TangGuoHua/smarthome/Docs/PIR.jpg

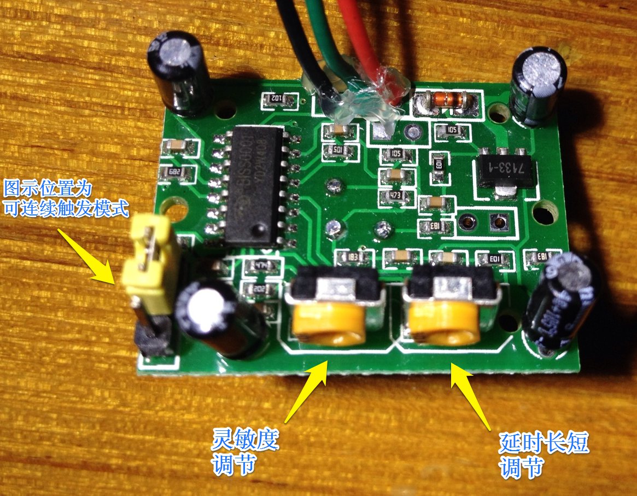
Docs/PIR.jpg
