TangGuoHua/smarthome/MCU/综合测试2/节点12 PWM调光/readme.txt

STC12C5608AD 1T单片机 4M外部晶振
主卧LED灯通过PWM调光
nrf24L01接收2个字节。字节1控制灯的亮度和延时关，字节2暂时没用
