TangGuoHua/smarthome/MCU/综合测试2/节点17 书房顶灯控制器/readme.txt

尽管这些文件都叫“报警器控制器XXX”，但是本节点确实用于控制书房的顶灯。
STC 11F04e 1T单片机
内部RC振荡器
nrf24L01无线模块
继电器
