TangGuoHua/smarthome/MCU/综合测试2/节点18 次卧控制器/readme.txt

节点18， 次卧控制器，ID1＝100， ID2＝18
STC11F04E 1T单片机 6.38MHz内部RC振荡器
NRF24L01+无线模块 (接收4个字节）
AM2321温湿度传感器 (DS18B20温度传感器 2013－FEB－27更换为AM2321)
2个继电器 分别控制床头灯（可以延时关）和加热器（可以控制温度）
