TangGuoHua/smarthome/MCU/综合测试2/节点15 电子钟/readme.txt

STC12C5608AD 
4M 外部晶振
nrf24L01+
4位共阳数码管
ds18B20 测温度

温度、时间交替显示
每5分钟通过nrf24L01传送一次当前亮度值和温度值
通过nrf24L01接受来自主机的校时信号
