TangGuoHua/smarthome/MCU/综合测试2/节点7 客厅控制器/readme.txt

STC 1T 12C5608AD 内部RC振荡 约7Mhz
AM2301 温湿度
NRF24L01 无线
2个继电器 

节点每5分钟发送一次温湿度值
节点接受来至主机的命令，控制继电器开闭
