TangGuoHua/smarthome/MCU/综合测试2/节点10_遥控灯开关/readme.txt

STC12C5608AD + 4M external crystal + NRF24L01P
遥控客厅的灯开
