TangGuoHua/smarthome/Docs/智能家控制器接线图.PNG

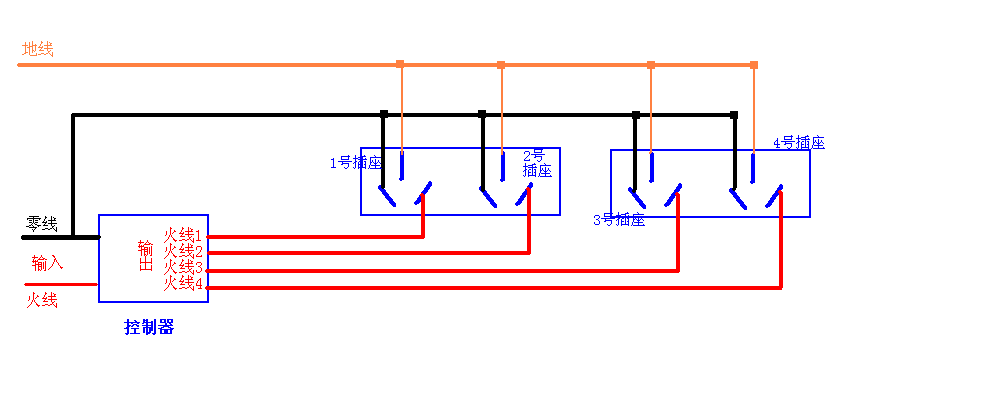
Docs/智能家控制器接线图.PNG
