TangGuoHua/smarthome/Docs/智能家架构.png

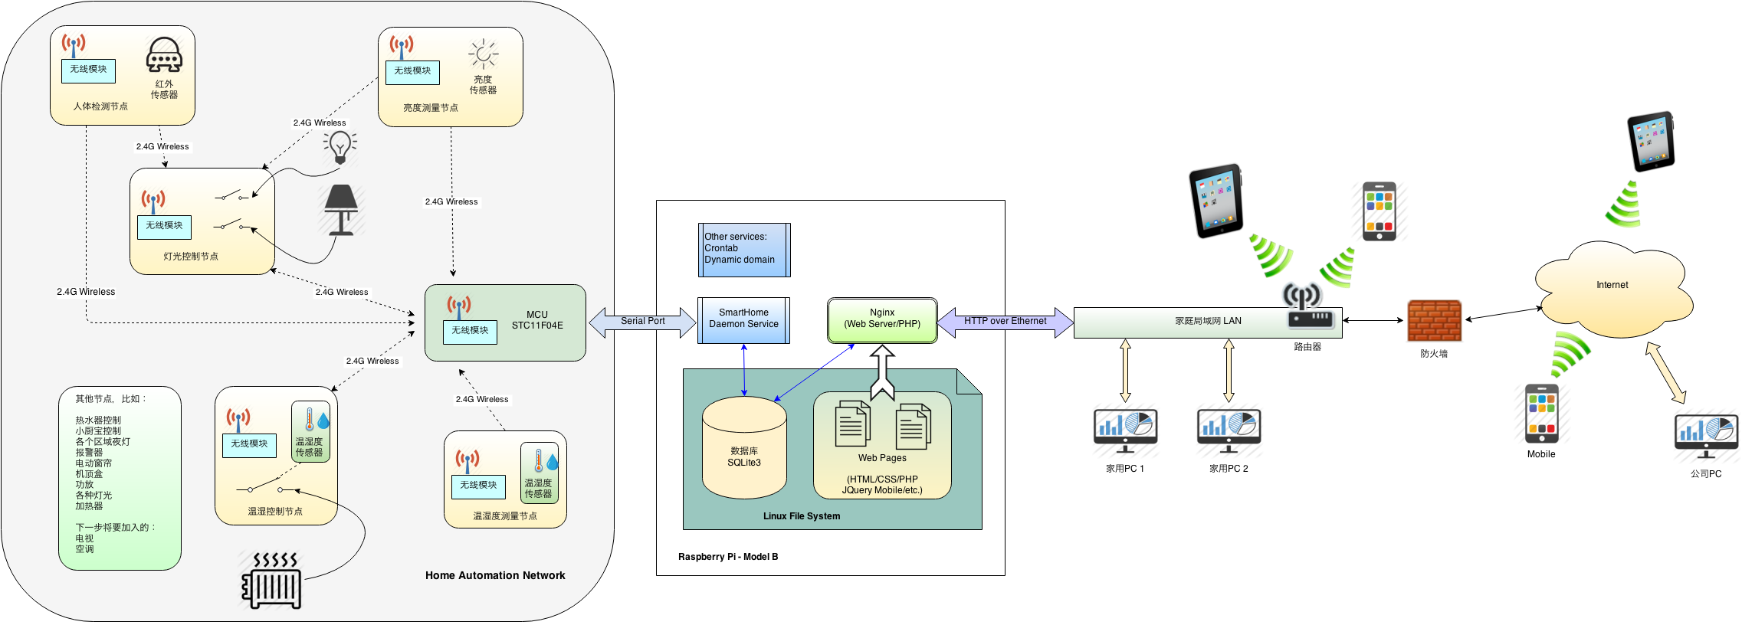
Docs/智能家架构.png
