TangGuoHua/smarthome/MCU/综合测试2/Doc/Node.xls

Sheet: 节点
编号 | 节点ID |  | 24L01接收频道 | 24L01接收地址 |  |  | 24L01接收字节数 | 节点描述
 | 字节0 | 字节1 |  | 字节0 | 字节1 | 字节2
1 | 48 | 1 | 96 | 54 | 69 | 149 | 15 | 主机节点，用于和上位机通信
2 | 144 | 1 | 92 | 97 | 83 | 149 | 2 | 温湿度节点。该节点具有一个DHT11湿度传感器和一个DS8B20温度传感器，一旦打开电源，每5秒，该节点将会向主节点发送一次温湿度数据。
3 | 144 | 2 | 92 | 97 | 83 | 153 | 0 | 热释电红外节点。该节点具有一个热释电红外传感器。一旦检测到信号，该节点将会发送一个数据包给主机。

Sheet: 说明
列名 | 说明
编号 | 从1开始的连续顺序号。显示表格的行号，统计节点个数等用处
节点ID | 这是我们自己的协议为每个节点编的一个ID号，每个节点的ID必须唯一，各节点间不能有重复ID出现。 每个节点的ID由2个字节组成。 高位字节（字节H）用于表示节点的类型。目前只有主节点（Master）和从节点（Slave）两种。一个类型下最多可以有256个节点（这个由下面的ID低位字节L决定）。 Master：0x30 Slave: 0x90 低位字节（字节L）用于表示某类型下节点的编号。取值范围是0到255。一般从1开始按顺序为该类型下的节点编号。 将高低两个字节组合在一起，就成为了一个2字节整型数，这个数可以用于上位机系统里面标识某一节点的唯一ID。 表格里面的十六进制和十进制数就是这个双字节整数。 理论上，我们的系统里面可以容纳的最大节点数是65536个，从0x0000-0xffff。
24L01接收频道 | 这是24L01的一个定义，即设定24L01为PRX时，其监听的频道是哪一个。 24L01支持0－125共126个频道，这个频道数（CH）也决定了24L01的接收频率，接收频率F=2400+CH （MHz）。 目前，在各个节点间通信时，我们使用同一个频道。（这个频道应该经过试验选择与现场干扰最小的频道，避开无线路由器等。) 另外，我看到网友的一个测试结果：发送频率越低，发送功率越高（我只是看到这个结果，网友没有说明测试条件等等，故此信息仅供参考。） 可以自己试验测试一下不同频率上的丢包率等来确定通信频率。
24L01接收地址 | 这是24L01的一个定义，即在设定24L01为PRX时为其设置的地址。这个地址决定了节点的接收地址。 我们的系统使用3字节地址，即，每个地址由3个字节组成：字节0、字节1、字节2.（24L01支持3－5个字节地址） 每个节点的硬件地址必须各不相同，不能有重复。 每个节点的硬件地址不得改变。 根据24L01的Datasheet：对于那些电平只有一次跳变（例如: 0x0000ff, 0xff8000等）和连续做高低跳变（例如：0xaaaaaa,0x555555等）的地址都容易引起系统误判为干扰，故不建议使用。 我们使用的地址规律：目前没有。（可以通过试验测试什么样的地址丢包率低,etc.）
24L01接收字节数 | 节点接收的每帧数据的字节数。取值范围0－32 这是24L01的定义，即设置24L01为PRX时，为其设定的每帧接收字节数。24L01每帧数据最多为32个字节。当初始化24L01为PRX时，这个值就定下来了。 如果一个节点接收字节数为0，则表示该节点不接收外界数据，即24L01不会工作在PRX模式。（这是我们自己协议的定义） 每个节点具体接收的报文内容请参考各节点的说明书。
