TangGuoHua/smarthome/PCB/controller.brd

## EAGLE design PCB/controller.brd (2015-01-24)

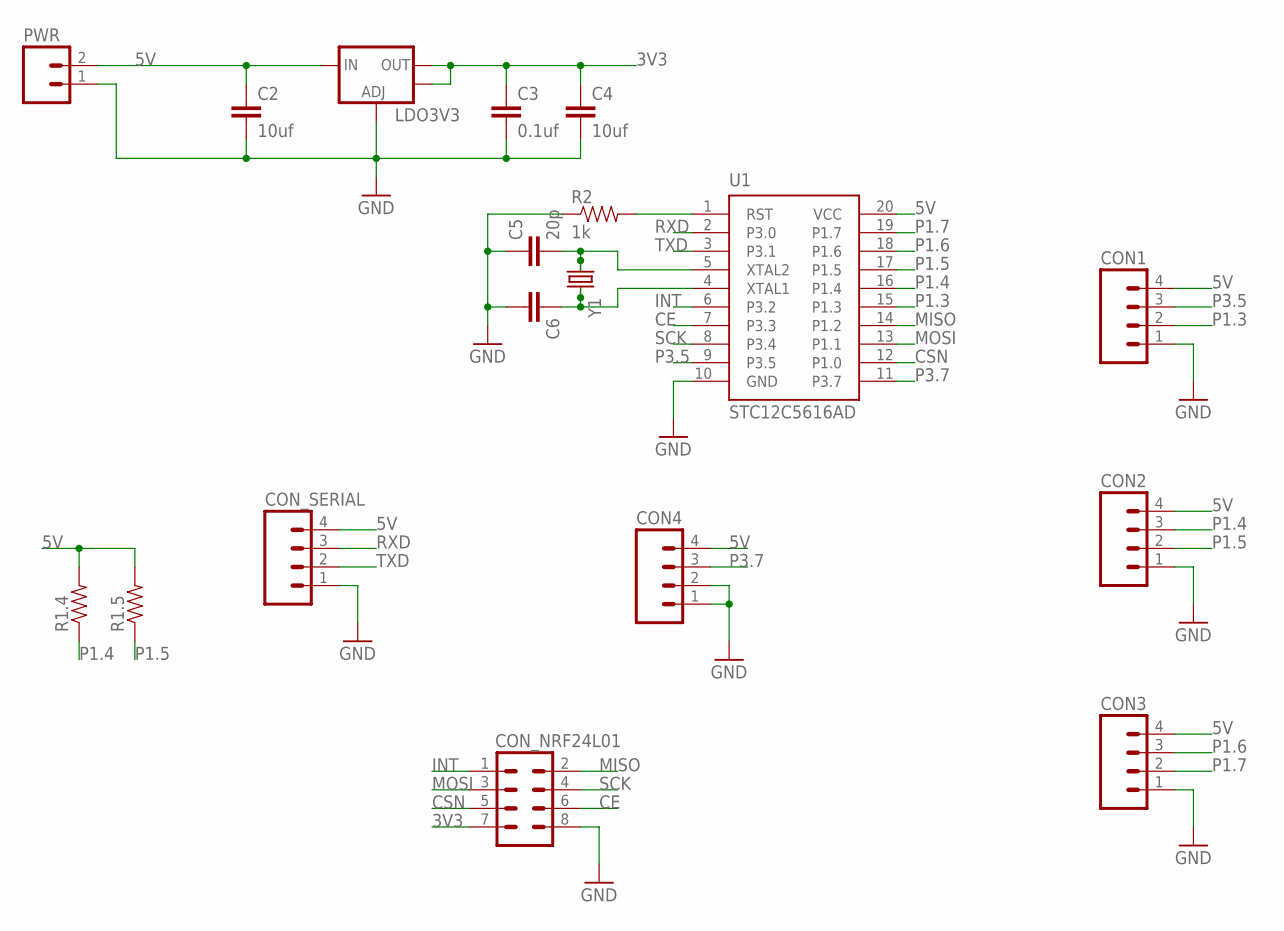
[picture p4: schematic controller.sch]

Parts:
C2, C4: 10uf; 0805
C3: 0.1uf; 0805
C5: 20p; 0603-CAP
C6: CAP0603-CAP; 0603-CAP
CON1, CON2, CON3, CON4: M04PTH; 1X04
CON_NRF24L01: M04X2; 2X4
CON_SERIAL: M04PTH; 1X04
LDO3V3: V_REG_LM1117SOT223; SOT223
PWR: M02PTH; 1X02
R1.4, R1.5: RESISTOR0805-RES; 0805
R2: 1k; 0805
U1: STC12C5616AD; SOP20
Y1: CRYSTALHC49US; HC49US

Connections:
3V3: C3.1, C4.1, CON_NRF24L01.7, LDO3V3.2 (OUT), LDO3V3.4 (OUT)
5V: C2.1, CON1.4, CON2.4, CON3.4, CON4.4, CON_SERIAL.4, LDO3V3.3 (IN), PWR.2, R1.4.2, R1.5.2, U1.20 (VCC)
CE: CON_NRF24L01.6, U1.7 (P3.3)
CSN: CON_NRF24L01.5, U1.12 (P1.0)
GND: C2.2, C3.2, C4.2, C5.1, C6.2, CON1.1, CON2.1, CON3.1, CON4.1, CON4.2, CON_NRF24L01.8, CON_SERIAL.1, LDO3V3.1 (ADJ), PWR.1, R2.1, U1.10 (GND)
INT: CON_NRF24L01.1, U1.6 (P3.2)
MISO: CON_NRF24L01.2, U1.14 (P1.2)
MOSI: CON_NRF24L01.3, U1.13 (P1.1)
unnamed: C5.2, U1.5 (XTAL2), Y1.1
unnamed: C6.1, U1.4 (XTAL1), Y1.2
unnamed: R2.2, U1.1 (RST)
P1.3: CON1.2, U1.15 (P1.3)
P1.4: CON2.3, R1.4.1, U1.16 (P1.4)
P1.5: CON2.2, R1.5.1, U1.17 (P1.5)
P1.6: CON3.3, U1.18 (P1.6)
P1.7: CON3.2, U1.19 (P1.7)
P3.5: CON1.3, U1.9 (P3.5)
P3.7: CON4.3, U1.11 (P3.7)
RXD: CON_SERIAL.3, U1.2 (P3.0)
SCK: CON_NRF24L01.4, U1.8 (P3.4)
TXD: CON_SERIAL.2, U1.3 (P3.1)

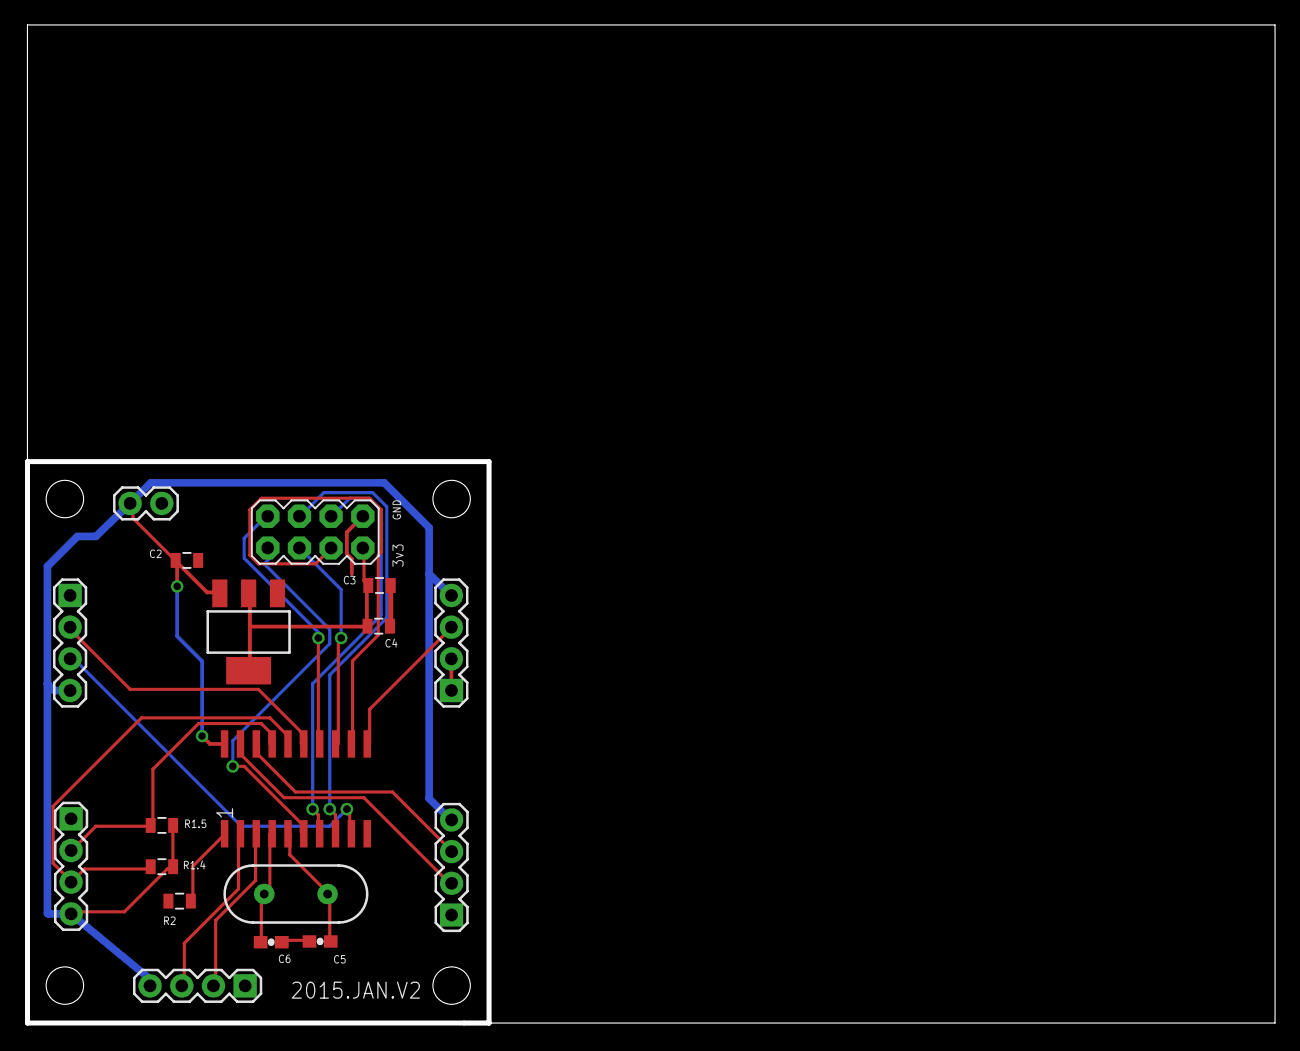
[picture p5: board controller.brd from above]

Board: 2 copper layers, 100.0 x 80.0 mm, 18 parts (0 on the bottom side), 21 nets.
