TangGuoHua/smarthome/Pi/smartHome/c/v2/nrf24L01.c

/***************************************************************************
【修改历史】

日期            作者    备注
----------------------------------------------------------------------
2014年08月20日  黄长浩  初始版本
2014年08月20日  黄长浩  修改nrfSendData()函数，增加rfPower, maxRetry参数
2014年09月23日  黄长浩  修改nrfSendData()函数，由于改用了带PA的模块（模块的LNA使能和CE相连），所以在发送数据后不能马上让CE=0，
                        一定要等收到ACK或者等发送失败后，才能让CE＝0。
2014年09月27日  黄长浩  修改nrfSendData()函数，使重发等待时间由1500us降到500us
                        修改nrfSetRxMode()和nrfSendData()函数，纠正以前地址宽度未设置的问题
2014年10月15日  黄长浩  nrfDataAvailable()取代nrfIsDataReceived()
                        nrfGetOneDataPacket()取代nrfGetReceivedData()
						支持从缓存FIFO读取多字节数据

【版权声明】
Copyright(C) All Rights Reserved by Changhao Huang (HuangChangHao@gmail.com)
版权所有者：黄长浩 HuangChangHao@gmail.com

未经作者书面授权，不可以将本程序此程序用于任何商业目的。
用于学习与参考目的，请在引用处注明版权和作者信息。
*****************************************************************************/

#include <wiringPi.h>
#include <stdio.h>
//#include <unistd.h>
#include "nrf24L01Def.h"

void nrfFlushTx();
void nrfFlushRx();
unsigned char nrfCheckSendStatus();

unsigned char nrfSPI( unsigned char spiData );
unsigned char nrfReadReg(  unsigned char regAddr );
unsigned char nrfWriteReg( unsigned char regAddr, unsigned char writeData);
unsigned char nrfReadRxData( unsigned char regAddr, unsigned char *rxData, unsigned char dataLen);
unsigned char nrfWriteTxData(unsigned char regAddr, unsigned char *txData, unsigned char dataLen);



//********* 以下函数仅供本模块内部调用 **************
//SPI时序函数
unsigned char nrfSPI( unsigned char spiData )
{
	unsigned char i;
	for(i=0;i<8;i++) //循环8次
	{
		if( spiData & 0x80 )
			//MOSI=1;
			digitalWrite( MOSI, HIGH );
		else
			digitalWrite( MOSI, LOW ); //byte最高位输出到MOSI
		spiData<<=1; //低一位移位到最高位
		//SCLK=1; 
		digitalWrite( SCLK, HIGH );
		
		//if(MISO) //拉高SCK，nRF24L01从MOSI读入1位数据，同时从MISO输出1位数据
		if( digitalRead( MISO )) 
			spiData|=0x01; //读MISO到byte最低位
		
		//SCLK=0; //SCK置低
		digitalWrite( SCLK, LOW );
	}
	return(spiData); //返回读出的一字节
}

//SPI读寄存器一字节函数
unsigned char nrfReadReg( unsigned char regAddr )
{
	unsigned char returnData;
	//CSN=0;//启动时序
	digitalWrite( CSN, LOW );
	nrfSPI( regAddr );//写寄存器地址
	returnData=nrfSPI(0x00);//写入读寄存器指令  
	//CSN=1;
	digitalWrite( CSN, HIGH );
	return( returnData ); //返回状态
}

//SPI写寄存器一字节函数
unsigned char nrfWriteReg( unsigned char regAddr, unsigned char writeData )
{
	unsigned char returnData;
	//CSN=0;//启动时序
	digitalWrite( CSN, LOW );
	returnData=nrfSPI(regAddr);//写入地址
	nrfSPI(writeData);//写入值
	//CSN=1;
	digitalWrite( CSN, HIGH );
	return(returnData);
}

//SPI读取RXFIFO寄存器的值
unsigned char nrfReadRxData( unsigned char regAddr, unsigned char *rxData, unsigned char dataLen )
{  //寄存器地址//读取数据存放变量//读取数据长度//用于接收
	unsigned char returnData,i;
	//CSN=0;//启动时序
	digitalWrite( CSN, LOW );
	returnData=nrfSPI(regAddr);//写入要读取的寄存器地址
	for(i=0;i<dataLen;i++) //读取数据
	{
		rxData[i]=nrfSPI(0);
	} 
	//CSN=1;
	digitalWrite( CSN, HIGH );
	return(returnData); 
}


//SPI写入TXFIFO寄存器的值
unsigned char nrfWriteTxData( unsigned char regAddr, unsigned char *txData, unsigned char dataLen )
{ //寄存器地址//写入数据存放变量//读取数据长度//用于发送
	unsigned char returnData,i;
	//CSN=0;
	digitalWrite( CSN, LOW );
	returnData=nrfSPI(regAddr);//写入要写入寄存器的地址
	for(i=0;i<dataLen;i++)//写入数据
	{
		nrfSPI(*txData++);
	}
	//CSN=1;
	digitalWrite( CSN, HIGH);
	return(returnData);
}


//Flush Tx Buffer
void nrfFlushTx()
{
	digitalWrite( CSN, LOW );//CSN=0;
	nrfSPI(FLUSH_TX);
	digitalWrite( CSN, HIGH );//CSN=1; 
}

//Flush Rx Buffer
void nrfFlushRx()
{
	digitalWrite( CSN, LOW );//CSN=0;
	nrfSPI(FLUSH_RX); 
	digitalWrite( CSN, HIGH );//CSN=1;
}


// 用于检查发送状态
// 返回值：252-不应该出现的返回值。（中断触发了，但既不是TX_DS也不是MAX_RT）
//         255-表示大重发次数达到后仍然未收到ACK，发送失败
//         0到15的一个值，表示发送完成且成功。返回值是自动重发的次数，例如：
//           0：没有重发，直接发送成功
//           1: 重发了1次后成功收到ack
//           2: 重发了2次后成功收到ack
//           以此类推
//           最大值是SETUP_RETR这个寄存器里面设置的最大重发次数。（不会超过15）
unsigned char nrfCheckSendStatus()
{
	unsigned char status;

	status = nrfReadReg(R_REGISTER+STATUS); //读取状态寄存器

	if( status & 0x20 ) //检查TX_DS位，置位则发送成功
	{
		nrfWriteReg(W_REGISTER+STATUS,0x7f);  // 清除TX_DS标志
		
		//发送成功后，FIFO自动清空，这里就不用再清了
		
		//返回自动重发次数
		return( nrfReadReg(R_REGISTER+OBSERVE_TX) & 0x0f ); 
	}
	else if( status & 0x10 ) //检查MAX_RT位，置位则说明最大重发次数达到后仍然未收到ACK，发送失败
	{
		nrfWriteReg(W_REGISTER+STATUS,0x7f);  // 清除MAX_RT标志
		
		//发送失败，FIFO不会自动清空，必须手动清空 ！！
		//关键！！不然会出现意想不到的后果！！！
		nrfFlushTx();

		return 255;
	}
	else
	{
		return 252; //不应该出现的一个值
	}
}


//******* 以下函数供外部模块调用 ************

//NRF24L01初始化函数
void nrf24L01Init()
{
	// initialize wiringPi lib
	wiringPiSetup();
	
	//Set pin mode
	pinMode( CE, OUTPUT );
	pinMode( CSN, OUTPUT );
	pinMode( SCLK, OUTPUT );
	pinMode( MOSI, OUTPUT );
	pinMode( MISO, INPUT );
	pinMode( IRQ, INPUT );
	
	//Set pull-ups
	pullUpDnControl( MISO, PUD_UP );
	pullUpDnControl( IRQ, PUD_UP );
	
	//delayFor24L01();//让系统什么都不干
	//delayFor24L01();//让系统什么都不干
	
	//CE=0; //待机模式1 (Standy-I)
	digitalWrite( CE, LOW );
	
	//CSN=1;
	digitalWrite( CSN, HIGH );
	
	//SCLK=0;
	digitalWrite( SCLK, LOW );
	
	/***下面这些寄存器的配置，在这个程序运行期间不变化，故在初始化芯片时配置。***/
	nrfWriteReg( W_REGISTER+EN_AA, 0x01 );     // 使能接收通道0自动应答
	nrfWriteReg( W_REGISTER+EN_RXADDR, 0x01 ); // 使能接收通道0

	//nrfWriteReg( W_REGISTER+SETUP_AW, 0x03 ); // Set up address width to 5 bytes
	nrfWriteReg( W_REGISTER+SETUP_RETR,0x7f ); // 自动重发延时等待2000us，自动重发15次
	nrfWriteReg( W_REGISTER+STATUS, 0x7e ); //清除RX_DR,TX_DS,MAX_RT状态位
	nrfWriteReg( W_REGISTER+CONFIG, 0x7e ); //屏蔽3个中断，CRC使能，2字节CRC校验，上电，PTX

	//delayFor24L01();
	//delayFor24L01();
	
	//flush buffers
	nrfFlushTx();
	nrfFlushRx();
}


// 将24L01设置为发送模式PTX，并发送数据
// 参数如下：
// rfChannel: 无线电频道  取值范围是0-125（即，0x00到0x7d）
// rfPower: 发射功率 取值1-4，
//          rfPower=1, 发射功率-18dBm (+7dBm with PA) 
//          rfPower=2, 发射功率-12dBm (+15dBm with PA) 
//          rfPower=3, 发射功率-6dBm (+20dBm with PA) 
//          rfPower=4, 发射功率0dBm (+22dBm with PA) 
// maxRetry: 如果发送不成功，重试的最大次数 取值范围0-9
//           0:如果发送失败，（特指nrf24l01+芯片Re-transmit 15次后仍然不成功），那么不重试，直接返回
//           1:如果发送失败，（特指nrf24l01+芯片Re-transmit 15次后仍然不成功），重试1次。以此类推。
//           特别说明，retry和retransmit的区别是：
//             芯片被设定为每次发送数据，如果一次transmission不成功，则自动再重传（retransmit）15次
//             而retry是指，在芯片自动重传了15次后，还是不成功的情况下，再发送一轮，即transmit (1+15)=16次
// addrWidth: 发送地址宽度
// txAddr: 发送的地址（接收方地址）
// dataWidth: 发送数据的宽度
// txData: 发送的数据
// 例子：
// unsigned char rfChannel = 0x64; //选择无线电频道
// unsigned char rec_addr[3]= { 0x54, 0x53, 0x95 };  //接收方地址
// unsigned char data_to_send[5] = {0x01, 0x02, 0x03, 0x04, 0x05 };　//要发送的数据
// nrfSendData( rfChannel, 1, 3, 3, rec_addr, 5, data_to_send );  //发送
//
// 返回值：本函数返回数据发送成功时，芯片重传（Re-transmit）的次数。
//   返回0：没有re-transmit，直接发送成功
//   返回1: 表示芯片re-transmit 1次成功
//   返回2：表示芯片re-transmit 2次成功
//   以此类推，最多re-transmit 159次成功。
//
//   返回251或252：都是系统异常情况。（其实这两个值都不应出现。）
//   返回253：表示本函数的入口参数有超过取值范围的，需要检查入口参数。
//   返回255：表示达到了重发次数达到后仍然未收到ACK，发送失败
unsigned char nrfSendData( unsigned char rfChannel, unsigned char rfPower, unsigned char maxRetry, unsigned char addrWidth, unsigned char *txAddr, unsigned char dataWidth, unsigned char *txData )
{
	unsigned char ret = 0;
	unsigned char retryCnt = 0;

	//检测各个参数是否在允许的取值范围内
	if( rfChannel>125 || rfPower==0 || rfPower>4 || maxRetry>9 || addrWidth<3 || addrWidth>5 || dataWidth==0 || dataWidth>32 )
	{
		return 253;
	}
	
	digitalWrite( CE, LOW );

	nrfWriteReg( W_REGISTER+SETUP_AW, addrWidth-2 ); //设置地址宽度
	nrfWriteTxData( W_REGISTER+TX_ADDR, txAddr, addrWidth ); //写寄存器指令+接收地址使能指令+接收地址+地址宽度
	nrfWriteTxData( W_REGISTER+RX_ADDR_P0, txAddr, addrWidth ); //为了应答接收设备，接收通道0地址和发送地址相同
	
	if(rfPower==1)
		nrfWriteReg( W_REGISTER+RF_SETUP,0x21 ); //数据传输率250Kbps，发射功率-18dBm (+7dBm with PA), LNA?
	else if(rfPower==2)
		nrfWriteReg( W_REGISTER+RF_SETUP,0x23 ); //数据传输率250Kbps，发射功率-12dBm (+15dBm with PA), LNA?
	else if(rfPower==3)
		nrfWriteReg( W_REGISTER+RF_SETUP,0x25 ); //数据传输率250Kbps，发射功率-6dBm (+20dBm with PA), LNA?
	else if(rfPower==4)
		nrfWriteReg( W_REGISTER+RF_SETUP,0x27 ); //数据传输率250Kbps，发射功率0dBm (+22dBm with PA), LNA?


	nrfWriteReg( W_REGISTER+RF_CH, rfChannel ); //选择射频通道
	nrfWriteReg( W_REGISTER+STATUS, 0x7f ); //清除RX_DR,TX_DS,MAX_RT标志
	nrfWriteReg( W_REGISTER+CONFIG, 0x4e ); //屏蔽RX_DR中断, 使能TX_DS和MAX_RT中断，CRC使能，2字节CRC校验，上电，PTX
	
	for( retryCnt=0; retryCnt<=maxRetry; retryCnt++ )
	{
		nrfWriteTxData( W_TX_PAYLOAD, txData, dataWidth ); //写入要发送的数据
		
		digitalWrite( CE, HIGH );
		while( digitalRead( IRQ ) ); //等待发送完毕（成功或达到最大重传次数）
		digitalWrite( CE, LOW ); //因为要使用AA，所以等中断产生后才能使CE=0，否则LNA无法工作
		
		ret=nrfCheckSendStatus();

		//printf( "retry count:[%d]\r\n", retryCnt );
		
		//如果返回值小于等于15，说明本次数据传送成功
		if( ret<=15 ) 
		{
			//计算函数返回值，即Retransmission的次数
			//一次性发送成功，返回0，即没有重传(re-transmission)
			//retry第1次时，一次性发送成功，则retransit 16次 （之前15次加本次）
			//一次类推，
			//retry第9次时，（加开始retry之前的一次，共发射了10次），retransmit 15次成功，则，总共retransmit了16*9+15=159次
			//每次try是transmit 16次 （本身1次，加15次retransmit）
			ret += (16*retryCnt);
			break;
		}
	}


	//printf( "cnt=%ld\n\r", timeoutCnt );
	//printf( "sending done.\n\r");
	
	return ret;
}


//设置24L01为接收模式PRX，准备接收数据
//参数如下：
//rfChannel：接收的频道号。取值范围是0－125
//addrWidth: 地址宽度（3-5字节）
//rxAddr：本节点接收的地址
//本节点的接收数据宽度在"nrf24L01Node.h"头文件里面设置
//例：
//   unsigned char myAddr[3] = {53, 69, 160};
//   nrfSetRxMode( 76, 3, myAddr);
//那么节点将在76频道上接收数据。地址宽度为3字节，地址是：53/69/160。
//一旦接收到数据，将触发INT0 (硬件接线提示：IRQ需连接到INT0上）
void nrfSetRxMode( unsigned char rfChannel, unsigned char addrWidth, unsigned char *rxAddr )
{
    digitalWrite( CE, LOW );

	nrfWriteReg( W_REGISTER+SETUP_AW, addrWidth-2 ); //设置地址宽度
  	nrfWriteTxData( W_REGISTER+RX_ADDR_P0, rxAddr, addrWidth ); //接收设备接收通道0使用和发送设备相同的发送地址
	nrfWriteReg( W_REGISTER+RF_CH, rfChannel ); //设置射频通道
  	nrfWriteReg( W_REGISTER+RX_PW_P0, RECEIVE_DATA_WIDTH ); //接收通道0选择和发送通道相同有效数据宽度
  	nrfWriteReg( W_REGISTER+RF_SETUP,0x27 ); // 数据传输率250Kbps，发射功率0dBm (+22dBm with PA), LNA?
	nrfWriteReg( W_REGISTER+STATUS, 0x7f ); // 清除RX_DR,TX_DS,MAX_RT标志
	nrfWriteReg( W_REGISTER+CONFIG, 0x3f ); //使能RX_DR中断，屏蔽TX_DS和MAX_RT中断，CRC使能，2字节CRC校验，上电，接收模式

  	digitalWrite( CE, HIGH ); //设为接收模式 PRX
}




//获取24L01接收到的一帧数据。
//由于nrf带有3个FIFO，所以应该用调用nrfDataAvailable()，循环读取一帧帧数据，直到nrfDataAvailable()返回0为止。
//注意：调用本函数前，请调用nrfDataAvailable()函数，确认有数据收到后，再调用本方法来取得24L01收到的数据
unsigned char* nrfGetOneDataPacket()				 
{
	static unsigned char dataBuffer[RECEIVE_DATA_WIDTH];
	//unsigned char status;
	
	//有人建议CE=0，再读取数据

	// 从RX FIFO读取数据
	nrfReadRxData(R_RX_PAYLOAD,dataBuffer,RECEIVE_DATA_WIDTH);
		
	return dataBuffer;
}


//是否收到数据?
//返回值: 1-收到数据， 0-未收到数据
//注意：本方法只能在PRX模式下使用！
unsigned char nrfDataAvailable()
{
	unsigned char status;
	
	if( ! digitalRead( IRQ ) )
	{
		//读取状态寄存器
		status = nrfReadReg(R_REGISTER+STATUS);
		if( status & 0x40 ) //检查RX_DR位，如果置位，则说明接收到数据
		{
			//读取FIFIO状态
			status = nrfReadReg(R_REGISTER+FIFO_STATUS);
			if( status & 0x01 )
			{
				//RX FIFO为空，说明FIFO里面没有数据了。
				//既然能进到这里来，说明RX_DR已经被置1
				//清掉RX_DR
				nrfWriteReg(W_REGISTER+STATUS,0x40);

				//用于清空FIFO ！！关键！！不然会出现意想不到的后果！！！大家记住！！
				//我经过试验发现，不清FIFO的话，发送方有时候会出现收不到ACK的现象
				//nrfFlushRx();
				
				//到外面去 return 0;
			}
			else
			{
				//RX FIFO非空，仍然有数据可以读
				return 1;
			}
		}
	}

	return 0;
}



/******************************************************************/

/*  以下方法不再使用


//函数功能:延时 15us
void delayFor24L01( )
{
	usleep(15); // needs #include <unistd.h>
	//delayMicroseconds(15); // needs #include <wiringPi.h>
}


//获取24L01接收到的数据。
//调用本函数前，请调用nrfIsDataReceived()函数，确认有数据收到后，再调用本方法来取得24L01收到的数据
unsigned char* nrfGetReceivedData()				 
{
	static unsigned char dataBuffer[RECEIVE_DATA_WIDTH];
	unsigned char status;
	
	//读取状态寄存器
	status = nrfReadReg(R_REGISTER+STATUS);
	if( status & 0x40 ) //检查RX_DR位，如果置位，则说明接收到数据
	{
		//CE=0;//进入Standby-I模式

		printf( "Data received. Status=%d, IRQ=%d, ", status , digitalRead( IRQ ));

		status = nrfReadReg(R_REGISTER+FIFO_STATUS);
		printf( "FIFO status=%d\n", status );
		
		// 从RX FIFO读取数据
		nrfReadRxData(R_RX_PAYLOAD,dataBuffer,RECEIVE_DATA_WIDTH);

		status = nrfReadReg(R_REGISTER+STATUS);
		printf( "After reading, Status=%d, IRQ=%d, ", status , digitalRead( IRQ ));

		status = nrfReadReg(R_REGISTER+FIFO_STATUS);
		printf( "FIFO status=%d\n", status );
		
		//接收到数据后RX_DR,TX_DS,MAX_PT都置高为1，通过写1来清除中断标
		//nrfWriteReg(W_REGISTER+STATUS,0xff);
		//网上找到的例子是用0xff来清中断标志，我通过试验发现用0x40也可以清掉RX_DR
		nrfWriteReg(W_REGISTER+STATUS,0x40);

		status = nrfReadReg(R_REGISTER+STATUS);
		printf( "After cleaning RX_DR, Status=%d, IRQ=%d, ", status , digitalRead( IRQ ));

		status = nrfReadReg(R_REGISTER+FIFO_STATUS);
		printf( "FIFO status=%d\n", status );
		
		//用于清空FIFO ！！关键！！不然会出现意想不到的后果！！！大家记住！！
		//我经过试验发现，不清FIFO的话，发送方有时候会出现收不到ACK的现象
		//nrfFlushRx();

		//status = nrfReadReg(R_REGISTER+STATUS);
		//printf( "After flush, Status=%d, ", status );

		//status = nrfReadReg(R_REGISTER+FIFO_STATUS);
		//printf( "FIFO status=%d\n", status );
	}
	return dataBuffer;
} 


//获取是否收到数据
//注意：本方法只能在PRX模式下使用！
//返回值: 1-收到数据， 0-未收到数据
unsigned char nrfIsDataReceived()
{
	return (! digitalRead( IRQ ) );
}

*/
