TangGuoHua/smarthome/MCU/综合测试2/新版测试/MCU/source/nrf24L01.h

/***************************************************************************
【修改历史】

日期            作者    备注
----------------------------------------------------------------------
2013年10月01日  黄长浩  初始版本

【版权声明】
Copyright(C) All Rights Reserved by Changhao Huang (HuangChangHao@gmail.com)
版权所有者：黄长浩 HuangChangHao@gmail.com

未经作者书面授权，不可以将本程序此程序用于任何商业目的。
用于学习与参考目的，请在引用处注明版权和作者信息。
****************************************************************************/

#ifndef __NRF24L01_H__
#define __NRF24L01_H__

/*******************命令寄存器***************************/
#define  R_REGISTER      0x00//读取配置寄存器
#define  W_REGISTER      0x20//写配置寄存器
#define  R_RX_PAYLOAD 	 0x61//读取RX有效数据
#define  W_TX_PAYLOAD	 0xa0//写TX有效数据
#define  FLUSH_TX		 0xe1//清除TXFIFO寄存器
#define  FLUSH_RX		 0xe2//清除RXFIFO寄存器
#define  REUSE_TX_PL     0xe3//重新使用上一包有效数据
#define  NOP             0xff//空操作
#define  W_TX_PAYLOAD_NOACK 0xB0	// Used in TX mode, Disable AUTOACK on this specific packet

/******************寄存器地址****************************/
#define  CONFIG          0x00//配置寄存器
#define  EN_AA			 0x01//使能自动应答
#define  EN_RXADDR       0x02//接收通道使能0-5个通道
#define  SETUP_AW        0x03//设置数据通道地址宽度3-5
#define  SETUP_RETR      0x04//建立自动重发
#define  RF_CH           0x05//射频通道设置
#define  RF_SETUP        0x06//射频寄存器
#define  STATUS          0x07//状态寄存器
#define  OBSERVE_TX      0x08//发送检测寄存器
#define  CD              0x09//载波
#define  RX_ADDR_P0      0x0a//数据通道0接收地址
#define  RX_ADDR_P1      0x0b//数据通道1接收地址
#define  RX_ADDR_P2      0x0c//数据通道2接收地址
#define  RX_ADDR_P3      0x0d//数据通道3接收地址
#define  RX_ADDR_P4      0x0e//数据通道4接收地址
#define  RX_ADDR_P5      0x0f//数据通道5接收地址
#define  TX_ADDR         0x10//发送地址
#define  RX_PW_P0        0x11//P0通道数据宽度设置
#define  RX_PW_P1        0x12//P1通道数据宽度设置
#define  RX_PW_P2        0x13//P2通道数据宽度设置
#define  RX_PW_P3        0x14//P3通道数据宽度设置
#define  RX_PW_P4        0x15//P4通道数据宽度设置
#define  RX_PW_P5        0x16//P5通道数据宽度设置
#define  FIFO_STATUS     0x17//FIFO状态寄存器
#define  FEATURE         0x1D// Additional features register, needed to enable the additional commands

/******************硬件接线*******************************/
/*  绿色PCB板用
sbit CE =  P3^3; //Pin3
sbit CSN=  P1^0; //Pin4
sbit SCLK= P3^4; //Pin5
sbit MOSI= P1^1; //Pin6
sbit MISO= P1^2; //Pin7
sbit IRQ = P3^2; //Pin8
*/

//手焊板用
sbit CE =  P2^5;
sbit CSN=  P3^4;
sbit SCLK= P2^4;
sbit MOSI= P3^3;
sbit MISO= P3^5;
sbit IRQ = P3^2;

#endif
