TangGuoHua/smarthome/MCU/新房/91_卫生间吊顶灯控热水器/source/nrf24L01Node.h

/***************************************************************************
【修改历史】

日期            作者    备注
----------------------------------------------------------------------
2013年10月01日  黄长浩  初始版本
2014年12月28日  黄长浩  修改为接收7字节

【版权声明】
Copyright(C) All Rights Reserved by Changhao Huang (HuangChangHao@gmail.com)
版权所有者：黄长浩 HuangChangHao@gmail.com

未经作者书面授权，不可以将本程序此程序用于任何商业目的。
用于学习与参考目的，请在引用处注明版权和作者信息。
****************************************************************************/

#ifndef __NRF24L01NODE_H__
#define __NRF24L01NODE_H__

#define RECEIVE_DATA_WIDTH 7 //本节点的接收的数据宽度 (1-32字节)

// ***** 相关函数声明 **********
void nrf24L01Init( void );
unsigned char nrfSendData( unsigned char rfChannel, unsigned char addrWidth, unsigned char *txAddr, unsigned char dataWidth, unsigned char *txData );
void nrfSetRxMode(  unsigned char rfChannel, unsigned char addrWidth, unsigned char *rxAddr);
unsigned char* nrfGetReceivedData( void );

#endif
