TangGuoHua/smarthome/MCU/综合测试2/节点1/source/dht11.c

/*
When        Who        Remarks
----------------------------------------------------------------------
2011-SEP-25 Changhao   Initial version
2011-OCT-07 Changhao   延长getHumidity()方法中两次采样间隔时间到2800ms。（刚才检测到一次数据出错，我怀疑是采样间隔时间不够造成的）
*/

#include <reg52.h>
#include "dataType.h"
#include "delay.h"
#include "dht11.h"


// 从DTH11读取一个字节的数据
byte getOneByte(void)
{
	byte i, temp, returnData, loopCount;
	
	
	for(i=0;i<8;i++)	   
	{
		loopCount = 200;
		while( !DHT11 && loopCount-- );
		delay10us();
		delay10us();
		delay10us();
		temp= DHT11?1:0;

		loopCount = 200;
		while( DHT11 && loopCount-- );
		//超时则跳出for循环		  
		
		returnData<<=1;
		returnData|=temp;
	}//rof
	
	return returnData;

}

// 读取DHT11传送的5个字节，但只返回湿度值
byte getAllBytes(void)
{
	byte temp, loopCount;
	byte tempHHigh, tempHLow, tempTHigh, tempTLow, tempCheckSum;
	byte returnData;
	
	//如果读取湿度不成功，则返回0xff，否则返回相对湿度值
	returnData = 0xff;
	
	//主机拉低20ms (要求大于18ms)
	DHT11=0;
	delay100us(200);
	DHT11=1;
	//总线由上拉电阻拉高 主机延时20us
	delay10us();
	delay10us();
	delay10us();
	delay10us();
	//主机设为输入 判断从机响应信号 
	DHT11=1;
	//判断从机是否有低电平响应信号 如不响应则跳出，响应则向下运行	  
	if(!DHT11)
	{
		loopCount = 200;
		//判断从机是否发出 80us 的低电平响应信号是否结束，或是否超时	 
		while( !DHT11 && loopCount-- );
		
		loopCount = 200;
		//判断从机是否发出 80us 的高电平，如发出则进入数据接收状态，或是否超时
		while( DHT11 && loopCount--  );
		//数据接收状态		 

		tempHHigh    = getOneByte();
		tempHLow     = getOneByte();
		tempTHigh    = getOneByte();
		tempTLow     = getOneByte();
		tempCheckSum = getOneByte();
		DHT11=1;
		
		//数据校验 
		
		temp = tempHHigh + tempHLow + tempTHigh + tempTLow;
		if( temp == tempCheckSum && temp>0 )
		{
			// 数据有效 返回湿度
			returnData = tempHHigh;
		}

	}// end if
	
	return returnData;

}

//--------------------------------
//-----湿度读取子程序 ------------
//--------------------------------
// 取得湿度值
// 有两种模式：0和1
// 模式0：调用getHumidity(0)实际取得的是上次读取时的测得湿度值，函数立即返回。
// 模式1：调用getHumidity(1)将取得当前的湿度值，但是函数需要2秒以上才返回。
byte getHumidity(bit mode)
{
	if( mode )
	{
	 	//每次读取DHT11的操作将返回上次测量的值，并触发一次测量
	 	//所以，为了得到最新的温湿度值，下面是连续2次读取，以获得最新值
		getAllBytes();
		delayMS(2800); // 两次读取间隔建议在2秒以上
	}
	return getAllBytes();
}


void initDHT11(void)
{
	DHT11 = 1;
}
