TangGuoHua/smarthome/MCU/综合测试2/节点1/source/dht11.h

/*
When        Who        Remarks
--------------------------------------
2011-SEP-25 Changhao   Initial version
*/

#ifndef __HDT11_H__
#define __HDT11_H__

//----------------------------------------------//
//----------------IO口定义区--------------------//
//----------------------------------------------//
sbit  DHT11  = P3^5 ;

// 函数定义
byte getHumidity(bit);
void initDHT11(void);
#endif
