TangGuoHua/smarthome/MCU/综合测试2/节点1/source/nrf24L01Node.h

#ifndef __NRF24L01NODE_H__
#define __NRF24L01NODE_H__


#define RECEIVE_DATA_WIDTH 2 //本节点的接收的数据宽度 2字节
#define RECEIVE_RF_CHANNEL 92 //本节点的接收频道号
#define HOST_RF_CHANNEL 96  //主机的接收频道号
#define HOST_DATA_WIDTH 15  //主机接收的数据宽度 15字节
#define ADDRESS_WIDTH 3 //发送和接收的地址宽度 3字节

static byte MY_ADDR[ADDRESS_WIDTH] = {97, 83, 149 }; //本节点地址
static byte HOST_ADDR[ADDRESS_WIDTH]= { 53, 69, 149 }; //主节点地址
//static byte dataBuffer[RECEIVE_DATA_WIDTH] ;

// ***** 相关函数声明 **********
void nrf24L01Init( void );
void nrfSendData( byte rfChannel, byte addrWidth, byte *txAddr, byte dataWidth, byte *txData );
void nrfSetRxMode( void );
byte* nrfGetReceivedData( void );

#endif
