TangGuoHua/smarthome/MCU/综合测试2/新版测试/MCU/source/am2321.h

#ifndef __AM2321_H__
#define __AM2321_H__

//----------------------------------------------//
//----------------IO口定义区--------------------//
//----------------------------------------------//
sbit  AM2321_SDA = P1^7;


// 函数定义
void initAM2321(void);
unsigned char readAM2321(); //readAM2321( unsigned char mode);
unsigned char getAM2321Data( unsigned char index );
#endif
