TangGuoHua/smarthome/MCU/综合测试2/节点16 客厅插座/MCU/source/am2301.h

#ifndef __AM2301_H__
#define __AM2301_H__

//----------------------------------------------//
//----------------IO口定义区--------------------//
//----------------------------------------------//
sbit  AM2301_SDA = P2^6;

// 函数定义
void initAM2301(void);
unsigned char readAM2301(unsigned char mode);
unsigned char getAM2301Data( unsigned char index );
#endif
