TangGuoHua/smarthome/MCU/综合测试2/节点9 声音/source/com.h

/*
When        Who        Remarks
--------------------------------------
2011-SEP-25 Changhao   Initial version
*/
#ifndef __COM_H__
#define __COM_H__

/*****************************************/
void serialPortInit(void);
void serialPortSendByte( unsigned char dat );
/*******************************************/
#endif
