TangGuoHua/smarthome/MCU/综合测试2/节点1/source/delay.c

/*
When        Who        Remarks
--------------------------------------
2011-SEP-25 Changhao   Initial version
*/

#include "delay.h"

/***************************延时函数****************/
void delay( uint t )
{
	uint x,y;
	for(x=t;x>0;x--)
		for(y=10;y>0;y--);
}


// 延时100us，11.0592M晶体
void delay100us( uint t )
{
	byte i;
	for(;t>0;t--)
		for(i=0;i<23;i++);
}

// 延时10us，11.0592M晶体
void delay10us(void)
{
	byte i;
	i++;
	i++;
	i++;
	i++;
	i++;
	i++;
}

void delayMS( uint t )
{
	uint i;
	for( ; t>0; t-- )
		for( i=114; i>0; i-- );
	
}
