TangGuoHua/smarthome/MCU/综合测试2/节点1/source/delay.h

/*
When        Who        Remarks
--------------------------------------
2011-SEP-25 Changhao   Initial version
*/
#ifndef __DELAY_H__
#define __DELAY_H__

#include "dataType.h"

/*****************************************/
void delay( uint t );
void delay100us( uint t );
void delay10us( void );
void delayMS( uint t );
/*******************************************/
#endif
