TangGuoHua/smarthome/(commit log)

2013-03-01 循环由2500改为6000次，防止readAM2321()函数误返回3
2013-03-02 correct some bugs for AM2321
    [am2321.c, main.c]
2013-03-02 餐厅灯控制器（节点3）增加PIR自动感应、向主机发送有无人信息的功能
2013-03-06 怀疑用单片机内部RC振荡频率随温度变化大，定时时间不准，温度变化后AM2321读取总是出错，所以加了4M外部晶体振荡器
2013-04-08 增加调光台灯
2013-04-08 为调光台灯实验做修改
2013-04-29 调光台灯增加延时关、闪光提示、渐亮渐暗等功能
2013-04-29 修改蓝绿调光LED为主卧台灯，并增加延时关功能
2013-05-11 AM2321返回3、4、5 三种出错代码，细化了。
2013-05-17 主卧调光台灯移到书房
2013-05-18 dnsdynamic.org今天无法访问，改用no-ip.com
2013-05-18 增加异常处理
2013-05-22 添加[新房]文件夹 节点23，厨房收音机初始版本
2013-05-23 增加厨房收音机
2013-06-01 用myip.dnsdynamic.org/来获得ip
2013-09-30 修改Pi和主机MCU的串口通讯率为115200bps 修改主机接收一帧数据为16字节 修改主机24L01模块程序
2013-10-13 初始亮度由255（全量）改为100
2013-10-14 1，增加光敏电阻 2，增加继电器2 3，继电器1和2均实现模式控制，增加自动模式 4，增加DS18B20
2013-11-08 增加餐厅射灯控制
2013-11-08 新增餐厅吊顶灯控模块
2013-11-24 增加开机延时initDelay 增加NODE_ID
2014-01-20 增加书房LED灯带开关
2014-01-26 增加温湿度的实时显示 修正Chart显示
2014-01-26 新增加客厅东墙北头暗盒节点
2014-01-27 增加initDelay()
2014-02-05 增加卫生间温度及小厨宝开关等
2014-02-05 增加卫生间南墙暗盒节点
2014-02-05 增加南卧暗盒节点
2014-02-05 增加南卧温湿度及油汀控制
2014-02-09 1号、2号灯分别设置开灯阈值
2014-02-09 厨房1、2号灯改为分别设定阈值
2014-02-11 2014年02月11日 黄长浩 修正AM2321读数全零的bug
2014-03-29 新增53号客厅东墙南头控制器节点
2014-03-30 主菜单增加“常用”
2014-06-29 2014-JUN-29 黄长浩 增加客厅电视背景墙控制器
2014-06-29 备份数据库
2014-07-13 增加卫生间热水器
2014-07-15 2014-JUL-15 黄长浩 增加餐厅灯带
2014-07-30 优化sqlite的synchronous/journal_mode/temp_store三个参数
2014-08-17 修改书房调光台灯亮度值
2014-08-21 hide some columns
    [智能家节点.xlsx]
2014-08-22 New board was soldered, and re-define hardware connections
2014-08-24 增加rfPower maxRetry参数
2014-09-05 增加52#节点，客厅吊顶射灯控制器
    [智能家节点.xlsx]
2014-09-14 2014-SEP-14 黄长浩 客厅吊顶射灯实现“全开全关”
2014-09-14 恢复10分钟采样
2014-09-23 修改nrf24l01+驱动，以使得带PA的模块可以收到Ack 增加tabDataSent 修改log.php样式
    [DatabaseDesign.xls]
2014-09-27 重新设计tabDataToNode表 nrf24l01+驱动修改，以支持3－5字节的收发地址
    [DatabaseDesign.xls]
2014-09-27 智能家2代上线
2014-09-28 一代主机的最终数据备份
2014-10-02 升级厨房灯控节点22，增加回传数据
2014-10-03 2014年10月03日 黄长浩 增加小厨宝自动工作模式 增加EEPROM保存数据 向Pi发送数据的延时由原10s延时计数改为timer0中断计数
2014-10-04 升级51号节点
2014-10-04 2014-OCT-04 黄长浩 电视背景墙控制器增加电视、电信机顶盒的控制 调整显示顺序按DisplayOrder排
2014-10-05 2014-OCT-05 黄长浩 tabDataSent表增加fldRequestor字段
2014-10-06 2014年10月06日 黄长浩 修改initDelay()延时为(NodeID*2)秒
2014-10-13 2014-OCT-05 黄长浩 增加execSql()方法，整理main()函数的主While循环结构
2014-10-15 2014年10月15日 黄长浩 nrfDataAvailable()取代nrfIsDataReceived() nrfGetOneDataPacket()取代nrfGetReceivedData() 支持从缓存FIFO读取多字节数据
2014-10-16 UTF8 without BOM
2014-10-19 2014-OCT-19 黄长浩 增加室外温度亮度（阳台）
2014-11-30 2014-NOV-30 黄长浩 增加客厅取暖器及温控
2014-11-30 2014年10月12日 黄长浩 增加取暖器温控
2014-11-30 增加功能号9－错误异常报告
    [智能家节点.xlsx]
2014-12-07 增加特定事件报告
    [智能家节点.xlsx]
2015-02-01 书房灯带节点升级
